asifajrof/CSE316_Term_Project_Tetris/README.md

# CSE316_Term_Project_Tetris
CSE316 Microcontroller et al. sessional. Term Project. Tetris with ATMega32, LED Dot Matrix, LCD, Thumb Joystick, Buzzer

A demonstration video: https://www.youtube.com/watch?v=KJl3XbOa1bw
