asifajrof/CSE316_Term_Project_Tetris/Proposal Present/CSE316_Proposal_Presentation_V3.pptx

## CSE316 Microprocessors, Microcontrollers, and Embedded Systems Sessional

Project Proposal

Group – 39
1705092 – Asif Ajrof
1705093 – Fatima Nawmi

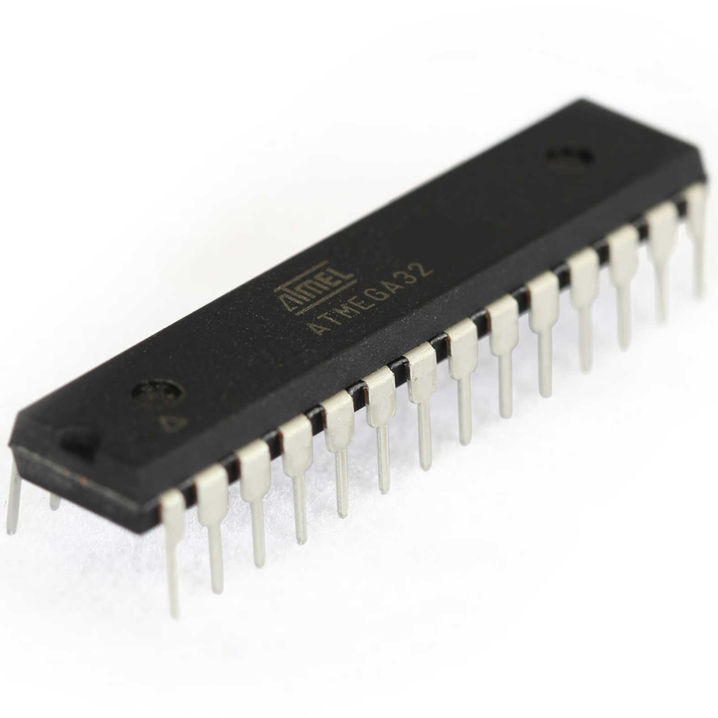
[picture p1: figure]
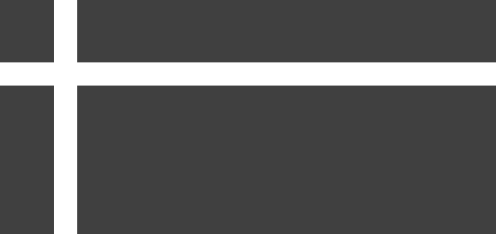
[picture p2: figure]
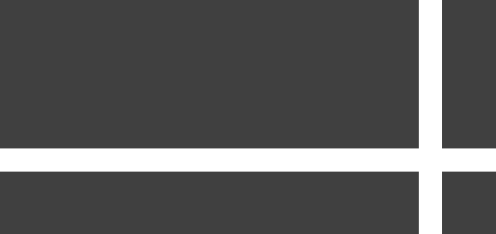
[picture p3: figure]

## What Are We Making?

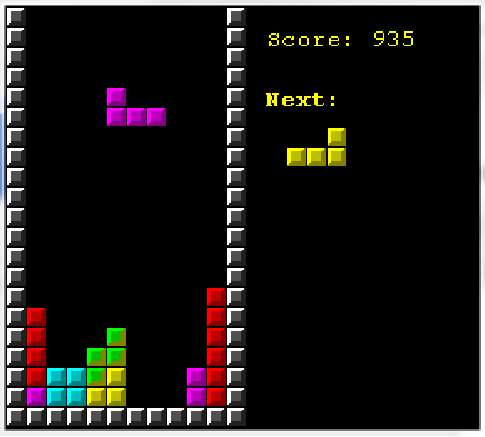
[picture p4: figure]
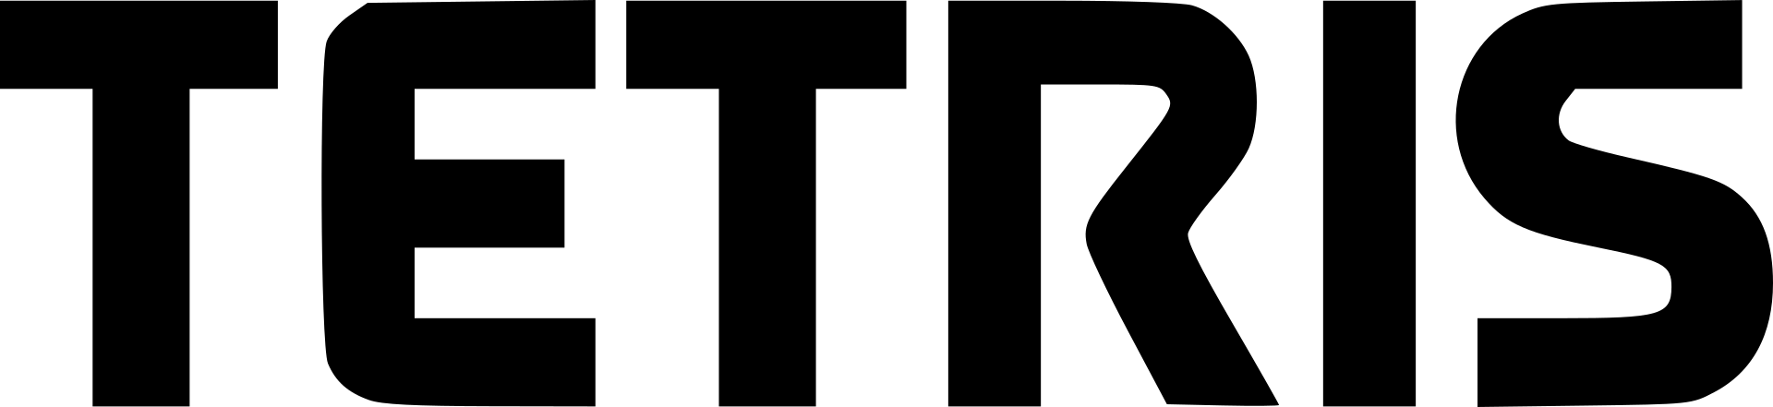
[picture p5: figure]

## Why TETRIS ?

- It will give us a good working knowledge of incorporating multiple components such as LED matrix, LCD screen, Buzzer, Thumb Joystick with Microcontroller.
- Implementing the logistics of the game we will learn first hand how to use logistics in real life hardware.
- Another reason for choosing this particular game is of course the reminiscence of the popular arcade game that we all played growing up.

## How Do We Implement ?

- For the game console we will use two LED dot matrices, and another LED dot matrix for showing the next piece.

## The Movement

- We will use a thumb joystick for movement and rotation of the pieces.
- A Tetris piece can be moved left or right to position and down to drop faster with the joystick.

## Score

- An LCD screen will show the score.
- When a row is filled, it disappears and one point is added. If four rows are filled in one move the point is double.
- The game finishes when the stack of pieces reach the top.

## Sound

- For sound effects, a buzzer will be used.
- The buzzer will make a beep sound on rotations and row fills.

## Components

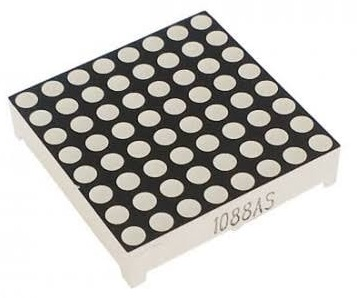
[picture p6: figure]

8x8 LED Dot Matrix 2.4’’

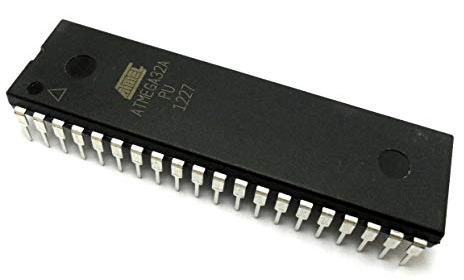
[picture p7: figure]

Microcontroller ATMEGA32

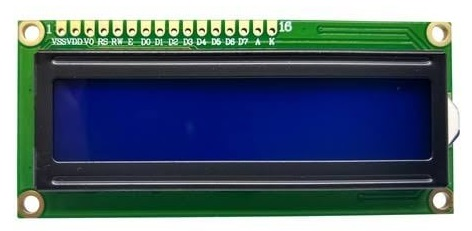
[picture p8: figure]

16x2 LCD Screen

## Components

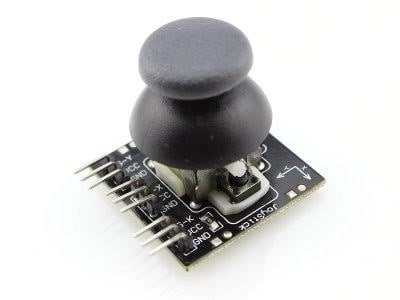
[picture p9: figure]

Analog 2-Axis
Thumb Joystick

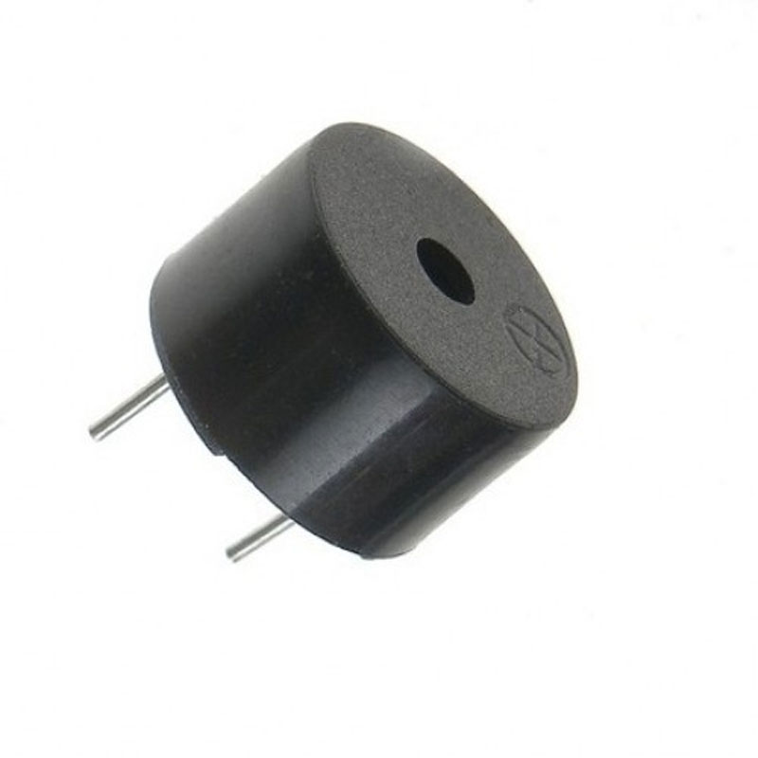
[picture p10: figure]

Buzzer

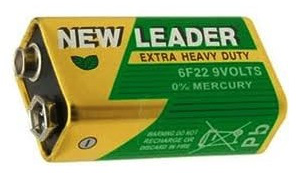
[picture p11: figure]

9V Battery

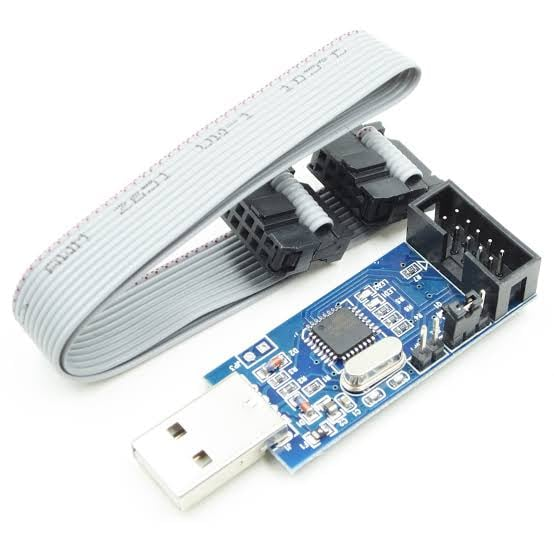
[picture p12: figure]

USBasp Programmer

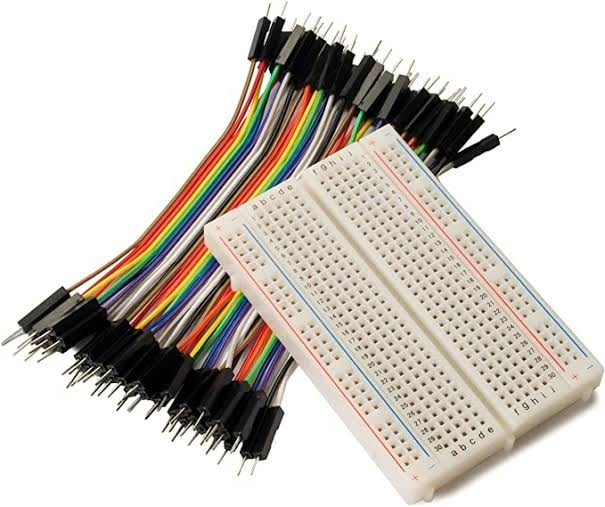
[picture p13: figure]

Breadboard
and Wiring

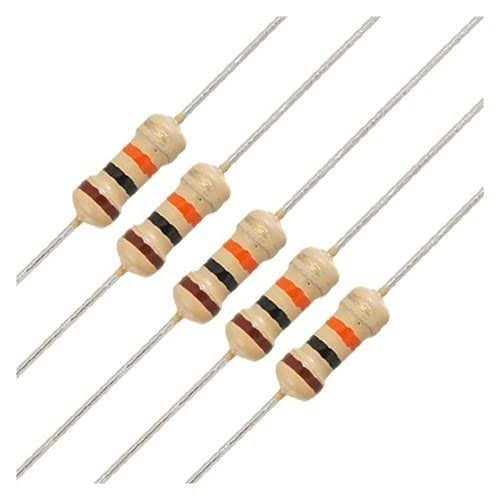
[picture p14: figure]

Resistors

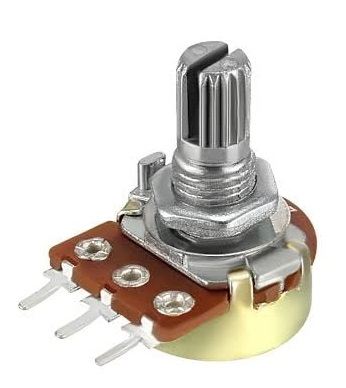
[picture p15: figure]

Potentiometer

## THANK YOU

1705092 – Asif Ajrof 1705093 – Fatima Nawmi
