asifajrof/CSE316_Term_Project_Tetris/Report Tex Project/Group-39-Report.pdf

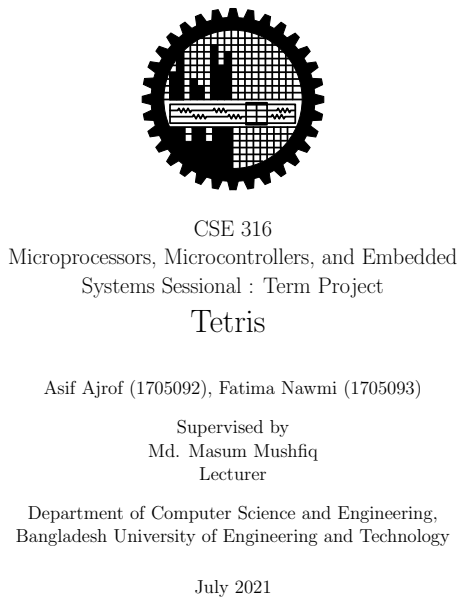
[picture p16: page 1]
CSE 316; Tetris; Lecturer; July 2021

Microprocessors, Microcontrollers, and Embedded

Systems Sessional : Term Project

Asif Ajrof (1705092), Fatima Nawmi (1705093)

Supervised by
Md. Masum Mushfiq

Department of Computer Science and Engineering,
Bangladesh University of Engineering and Technology

## Contents

1 Motivation | 1
2 Components | 1
3 Short Description of Each Module | 1
4 Methods used | 2
5 Algorithm used in gameplay | 3
6 Circuit Diagram | 3
7 Challenges | 5

i

1

## 1 Motivation

Remaking the popular arcade game Tetris in a simple platform using microcontroller and LED matrices.

## 2 Components

The main components of our project are:

1. ATmega32
2. 8x8 LED Dot Matrix (common cathode)
3. 16x2 LCD Screen
4. Thumb Joystick
5. Buzzer

Some other components that were also used:

- USBasp
- Resistor
- Inductor
- Capacitor
- Wire
- Potentiometer

## 3 Short Description of Each Module

We have several different modules in this project. Here is a short description summarizing what each module does individually.

### 3.1 Main Console

The main gaming console is made of two 8x8 LED Dot Matrix, so we have a 16x8 display for the gameplay.

### 3.2 Pieces

We have kept all the 7 different pieces of Tetris game (I,J,L,T,S,Z,O). The pieces are generated randomly, and for each game the pieces are random as well.

We show the next piece to come in the LCD screen.For this we have ensured communication between two ATmega32.

2

### 3.3 Movement

The thumb joystick is used for four possible movements: left, right, down and rotate (up move of joystick). Also, for starting the game we need an up move.

### 3.4 Score Update

When a row is filled the score is updated in the LCD screen and the filled row is removed while the rows above come down to fill up the empty row. When four consecutive rows are filled at the same time, as a bonus double points are added.

### 3.5 Game Speed

After certain time intervals, the game increases its speed. The speed resets when a new game is started again.

### 3.6 Sound

The buzzer makes a sound when there is a score update, a new game starting and when the game is over.

### 3.7 Game over and New game

When there is no more place for a new piece to enter, the game is over. For a new game to begin after the last game is over,the display shows a play button and an up movement is needed.

## 4 Methods used

### 4.1 UART

For having a simplex data transfer we used UART subsystem. We used 9600 bps baud rate for data transmission.

### 4.2 ADC

We have used the ADC chip for collecting analogue movement data from the thumb joystick and converted it to digital for our piece movements.

3

## 5 Algorithm used in gameplay

The algorithm used in gameplay is shown in the following flowchart,

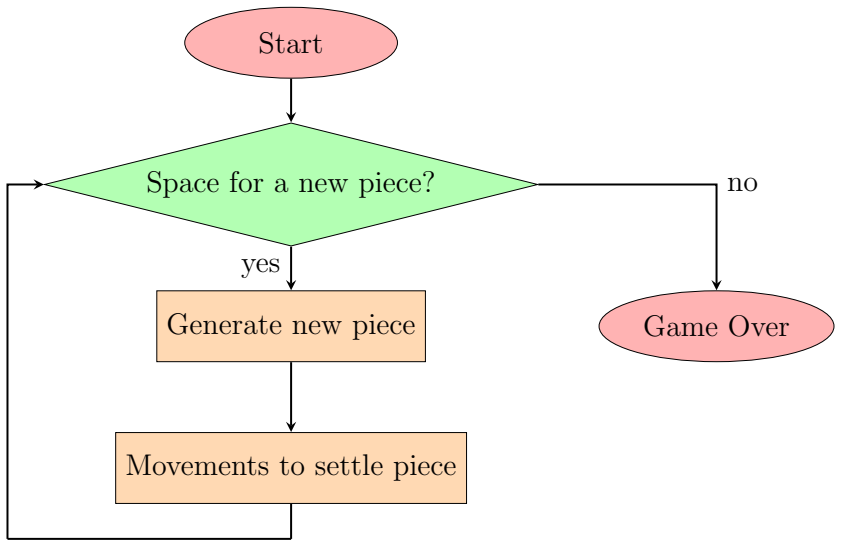
[picture p17: figure]
Start; Space for a new piece?; Generate new piece; Game Over; Movements to settle piece; yes

Figure 1: Algorithm

## 6 Circuit Diagram

- We have used two ATmega32 microcontrollers, U1 and U2 in the Figure 2.
- The main console, i.e., two LED dot matrices are connected to U1. Since we have used two common cathode LED matrices, we have used P ORT C for the common row connection for both LED matrices. For column connection we have connected the upper LED matrix to P ORT B and the lower LED matrix to P A4 − P A7 and P D4 − P D7.
- As we have connected the thumb joystick using the ADC0, ADC1 input, it is connected to P A0 − P A1, also the ground pin of the joystick is connected to the common ground of the circuit and the power pin to the common power source, V CC. We have used AV CC as the voltage source for ADC and for better accuracy and stable voltage we have connected a capacitor (C2) between ground and AREF, another one (C3) between ground and AV CC. For stable current flow we have used an inductor (L1) between AV CC and V CC.
- We have connected the positive end of the the buzzer to P A2 and the negative end to the ground.

4

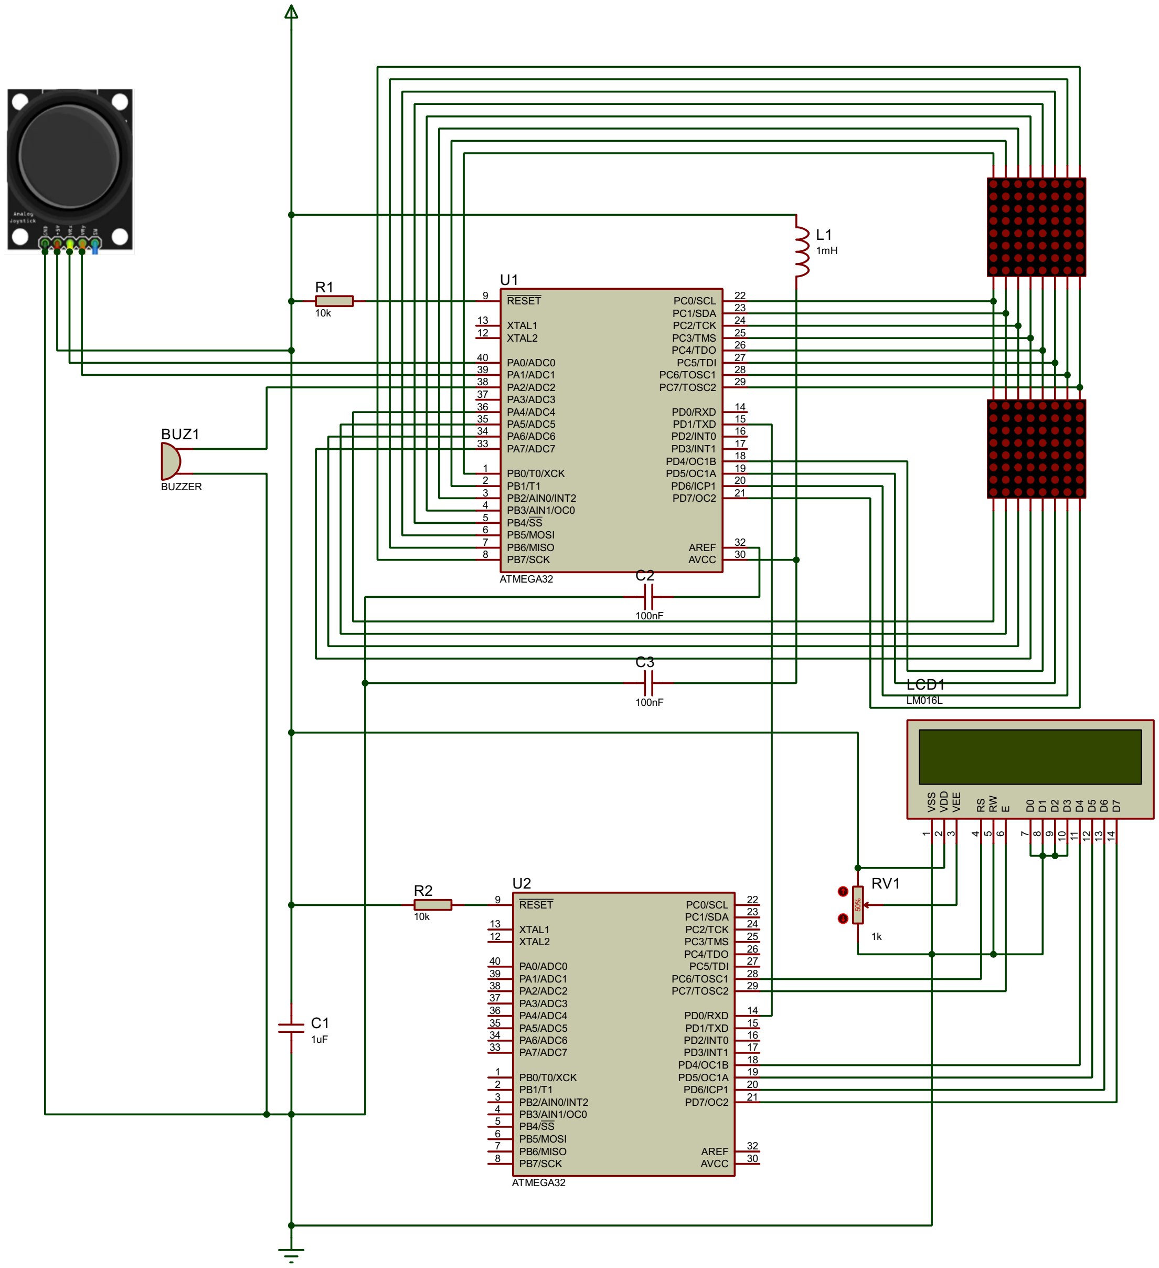
[picture p18: figure]
PB0/T0/XCK; PB2/AIN0/INT2; PB3/AIN1/OC0; PB5/MOSI 6; PB6/MISO; PB7/SCK; RESET; XTAL2; XTAL1; PD0/RXD; 14 PD1/TXD 15 PD2/INT0 16 PD3/INT1 17 PD4/OC1B 18 PD5/OC1A 19 PD6/ICP1 20 PD7/OC2 21; PC0/SCL; 22 PC1/SDA 23 PC2/TCK 24 PC3/TMS 25 PC4/TDO; 26 PC5/TDI; 27 PC6/TOSC1; 28 PC7/TOSC2 29 PA7/ADC7; PA6/ADC6; PA5/ADC5; PA4/ADC4; PA3/ADC3; PA2/ADC2; PA1/ADC1; PA0/ADC0; AREF; 32 AVCC 30; ATMEGA32; BUZ1; BUZZER; 4 VSS; 1 VDD 2 VEE; 3 LCD1

Figure 2: Detailed Pin Diagram

- For establishing UART serial communication between U1 and U2 we have connected the TXD (P D1) pin of U1 to the RXD (P D0) pin of U2.
- We have connected the LCD to U2, using P D4 − P D7 as data lines D4 − D7, and P C6, P C7 as register select and enable pins respectively. As we have used the LCD for only write operations, the Read/Write pin is constantly kept low by connecting it to the ground. Since we have used 4-Bit Mode Interfacing, data pins D0 − D3 are connected to the ground. The V EE pin is connected to a potentiometer for changing the contrast of the display. The V DD pin is connected to power source and the V SS pin is connected to the ground.
- For ensuring stable source voltage we have used a capacitor between source voltage and ground in both U1 and U2 and the reset pin is connected to the V CC.

5

## 7 Challenges

- We noticed that while using UART serial communication the data transfer was delayed by few seconds, for fixing this we tried using a larger Baud rate for a larger bit per second, but after some trial and error even with a larger Baud rate there was some delay, hence when the score gets updated or game over or a new game there is a slight delay before the LCD is updated.
- We faced a problem in our main display LED matrices, every next row was emitting very dim light under the actual positions. We figured since we are multiplexing the rows and columns, and we are changing the row values first and then changing the column values, as a result for a very brief time the columns are getting previous values for an updated row value. We fixed this problem by clearing the values of columns after a short delay in each iteration.
- While implementing the movements a delay was needed because without delay a single press would trigger multiple moves. But a delay function for every movement pauses all the other functionalities. So, instead we kept a variable, that keeps count of the duration of one button press and ensures one movement for one press.
- While designing our main circuit we first wanted to use one ATmega32 with the help of decoders for all our operations. We tried simulating this with Proteus, but we noticed because of using decoder the entire process was becoming very slow. So we excluded this idea from the designing phase and designed with two ATmega32 which also enabled us to learn about the serial communication method.
- Even though we needed simplex serial communication between the two microcontrollers we found that if we did not enable the RXC and TXC of UCSRA registers in both ATmega32 code, it was not working in hardware, but it was working in simulation. Hence we used duplex mode for implementing simplex communication.
- LCD showed garbage values if there was a slight change in voltage, after reconnecting the voltage source this problem went away. For solving this issue we have called the LCD initialization function every time before we write something on the LCD. This clears the garbage values without the necessity to reset.
- Implementing all the logistics of the game into hardware was very challenging. Implementing the same tasks in simulator was widely different than implementing it in hardware.
