asifajrof/CSE316_Term_Project_Tetris/Proposal Present/CSE316.Term.Project.Proposal.Presentation.Group.39.pdf

## Project Proposal

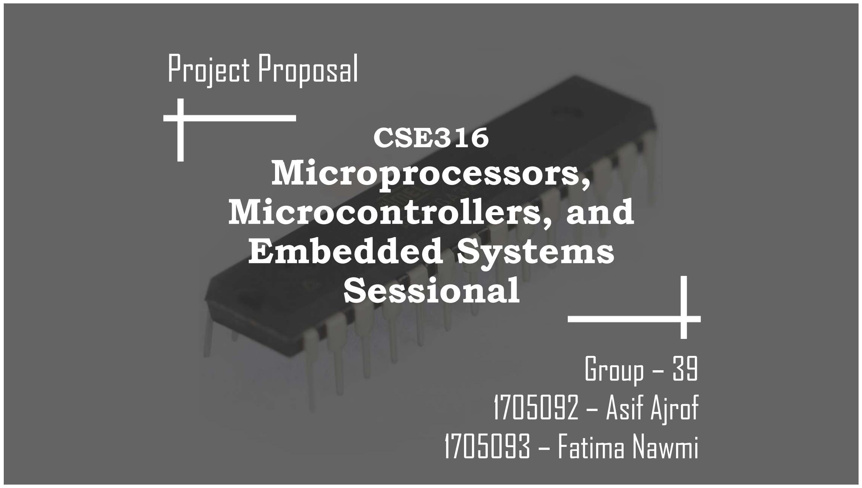
[picture p19: page 1]

CSE316
Microprocessors,

## Microcontrollers, and Embedded Systems Sessional

### Group – 39 1705092 – Asif Ajrof 1705093 – Fatima Nawmi

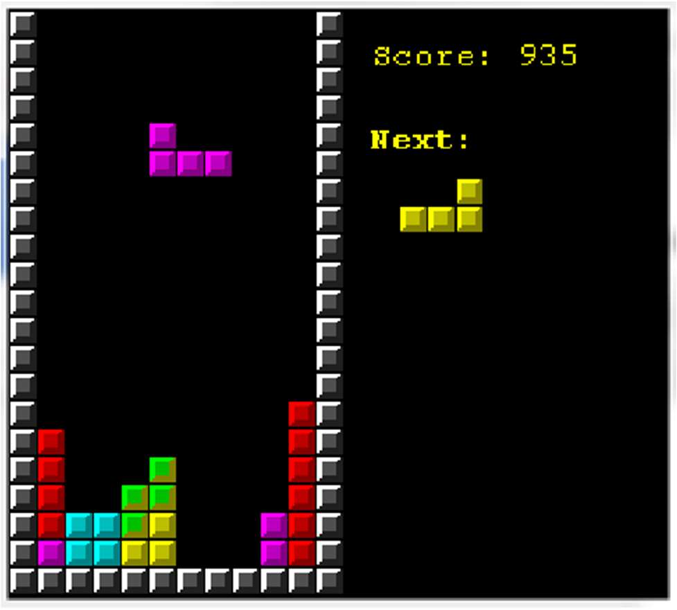
[picture p20: figure]

## What Are We Making?

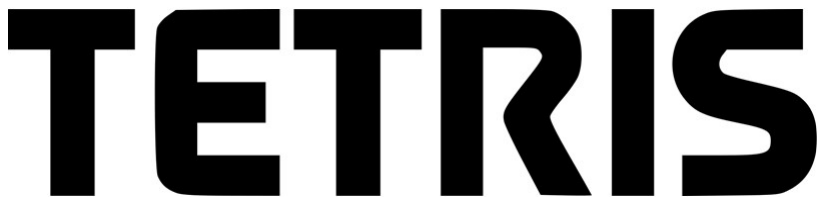
[picture p21: figure]

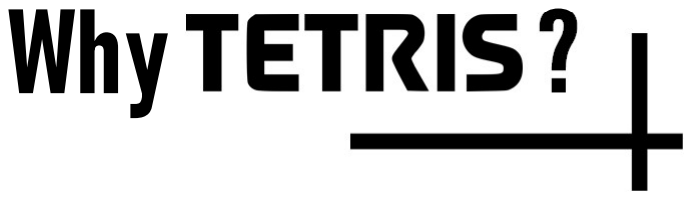
[picture p22: figure]
Why TETRIS ?

It will give us a good working knowledge of incorporating multiple components such as LED matrix, LCD screen, Buzzer, Thumb Joystick with Microcontroller.
Implementing the logistics of the game we will learn first hand how to use logistics in real life hardware.
Another reason for choosing this particular game is of course the reminiscence of the popular arcade game that we all played growing up.

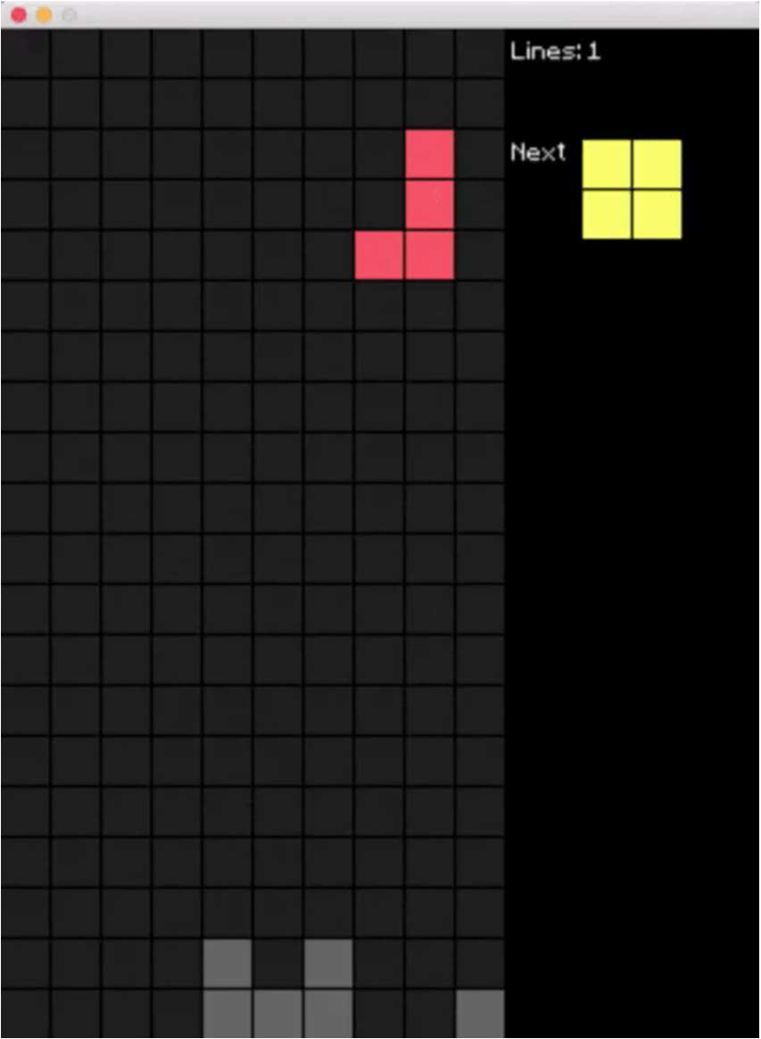
[picture p23: figure]

## How Do We Implement ?

For the game console we will use two LED dot matrices, and another LED dot matrix for showing the next piece.

## The Movement

We will use a thumb joystick for movement and rotation of the pieces. A Tetris piece can be moved left or right to position and down to drop faster with the joystick.

## Score

An LCD screen will show the score. When a row is filled, it disappears and one point is added. If four rows are filled in one move the point is double.
The game finishes when the stack of pieces reach the top.

## Sound

For sound effects, a buzzer will be used.
The buzzer will make a beep sound on rotations and row fills.

## Components

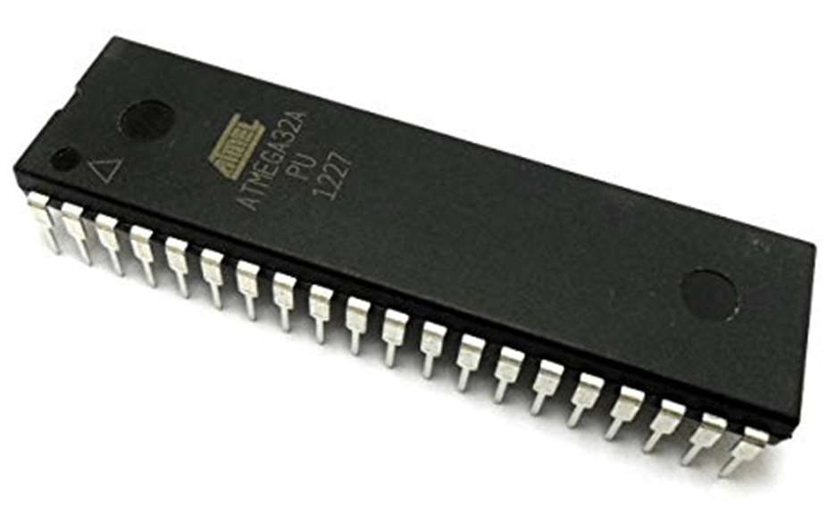
[picture p24: figure]

Microcontroller
ATMEGA32

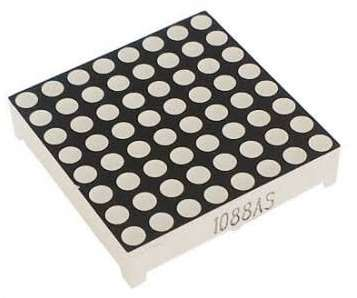
[picture p25: figure]

8x8 LED Dot Matrix 2.4’’

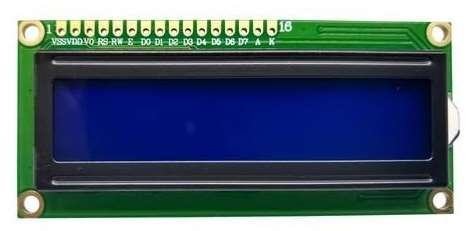
[picture p26: figure]

16x2 LCD Screen

## Components

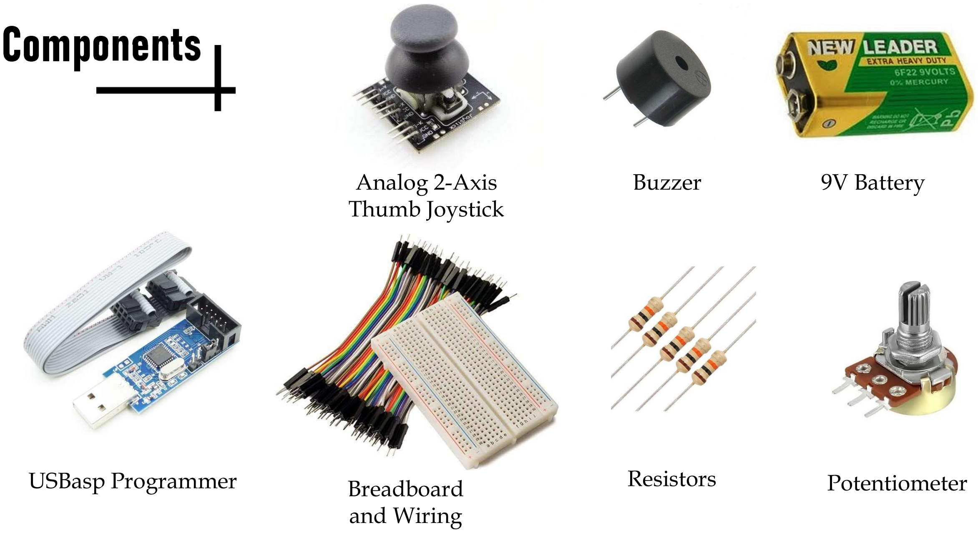
[picture p27: page 9]

Analog 2-Axis
Thumb Joystick

Buzzer

USBasp Programmer

9V Battery

Breadboard | Resistors | Potentiometer
and Wiring

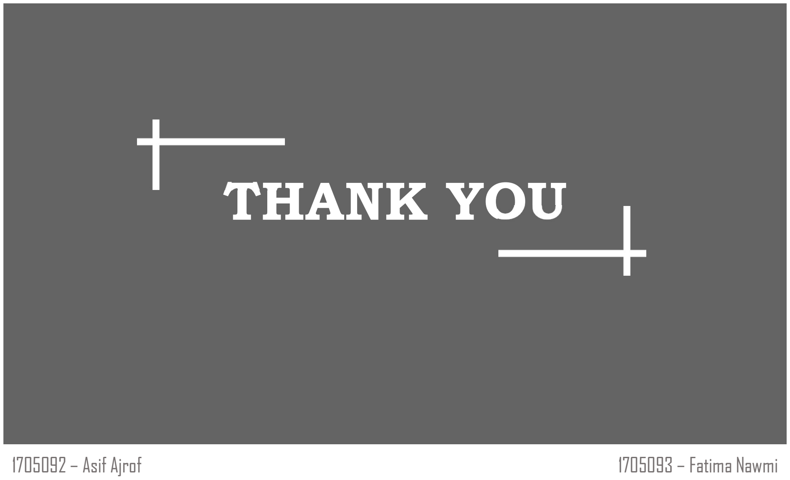
[picture p28: page 10]

# THANK YOU

1705092 – Asif Ajrof | 1705093 – Fatima Nawmi
