asifajrof/CSE316_Term_Project_Tetris/Report Tex Project/figures/BUET_logo.pdf

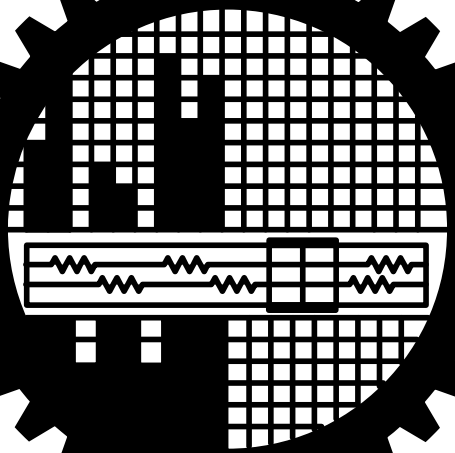
[picture p29: figure]
