asifajrof/CSE316_Term_Project_Tetris/Circuits/finalckt.png

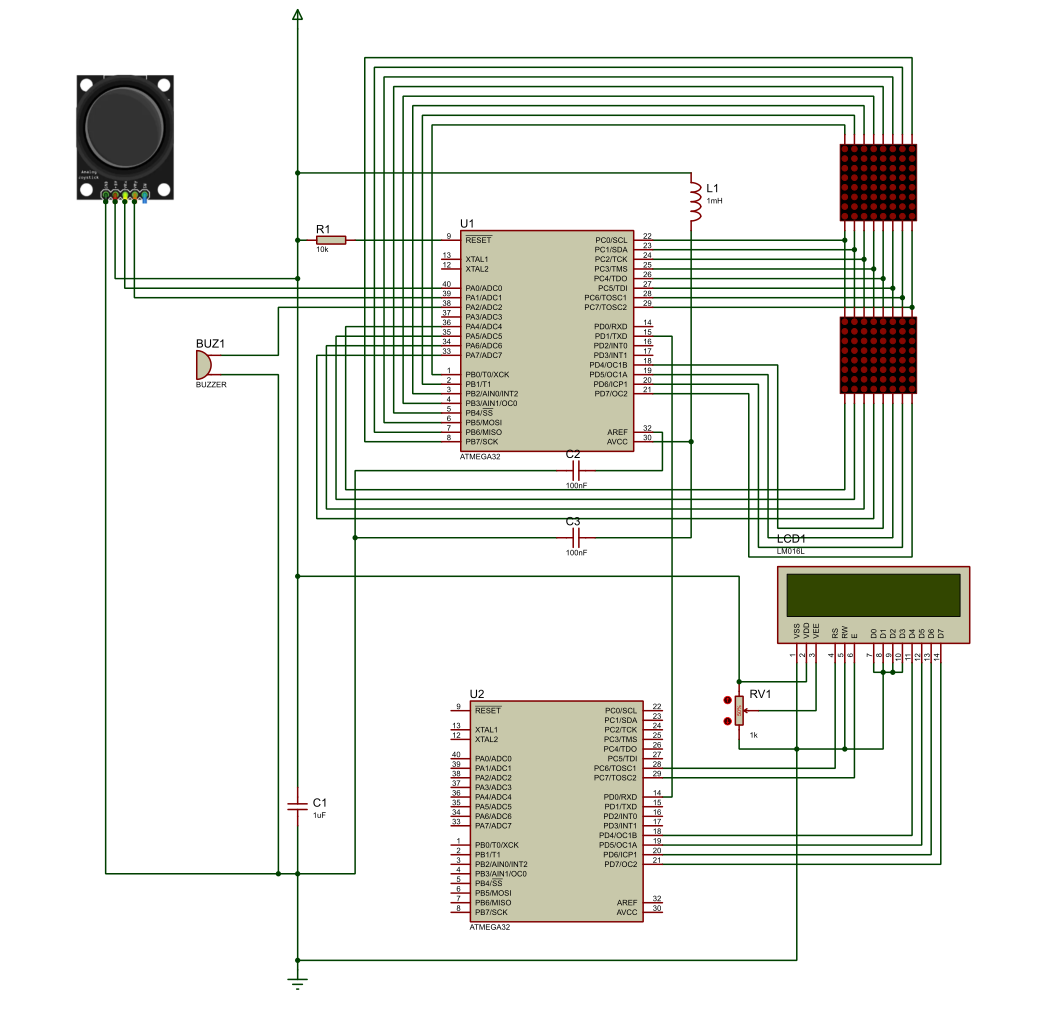
Circuits/finalckt.png
