asifajrof/CSE316_Term_Project_Tetris/workfiles/shapes.png

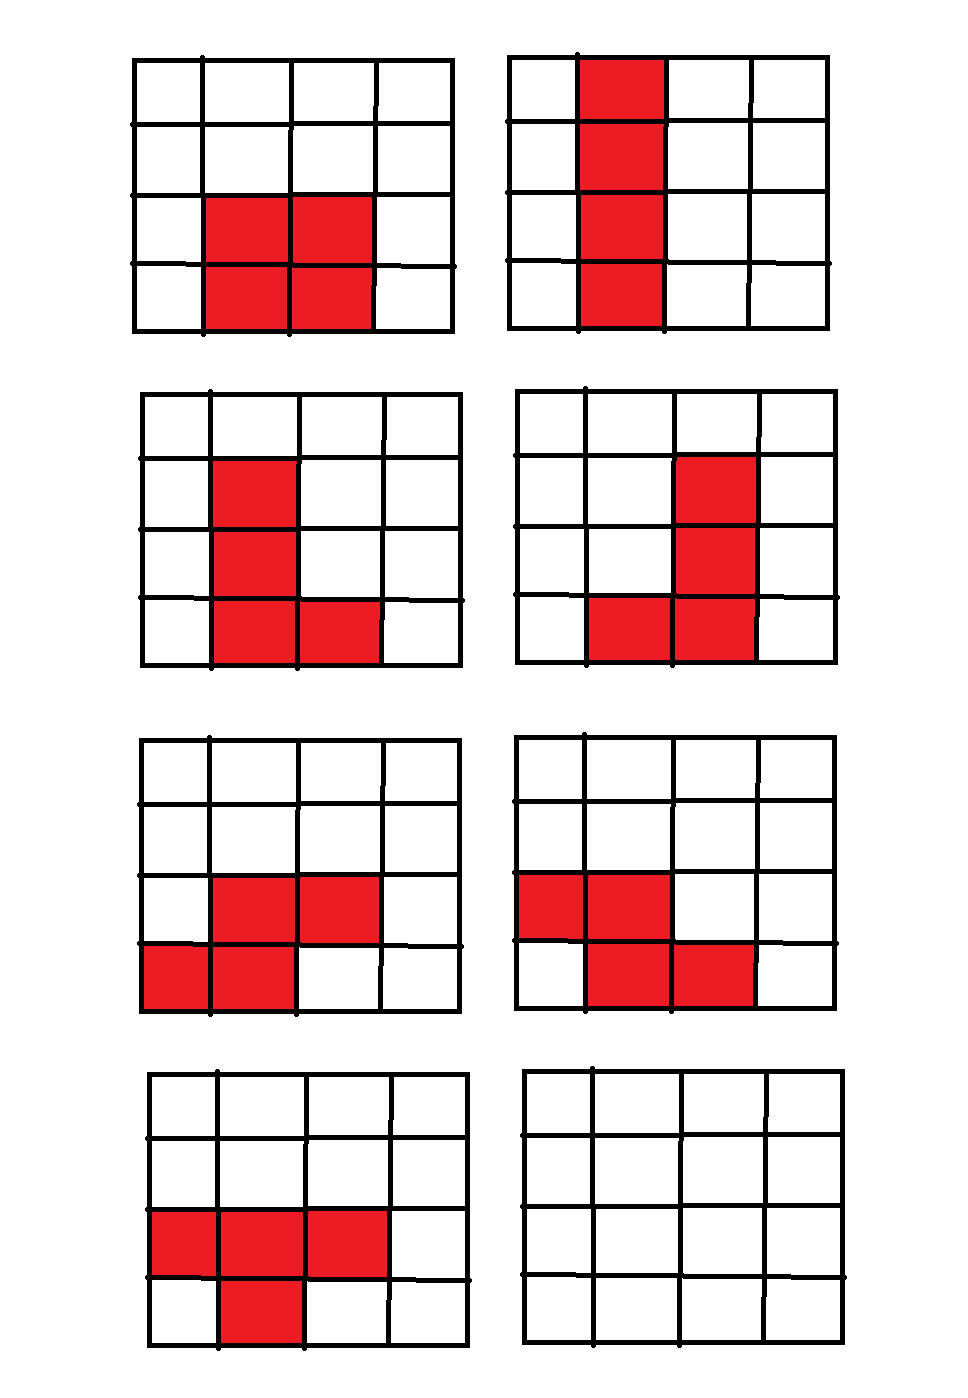
workfiles/shapes.png
