asifajrof/CSE316_Term_Project_Tetris/Report Tex Project/figures/circuit_final1.pdf

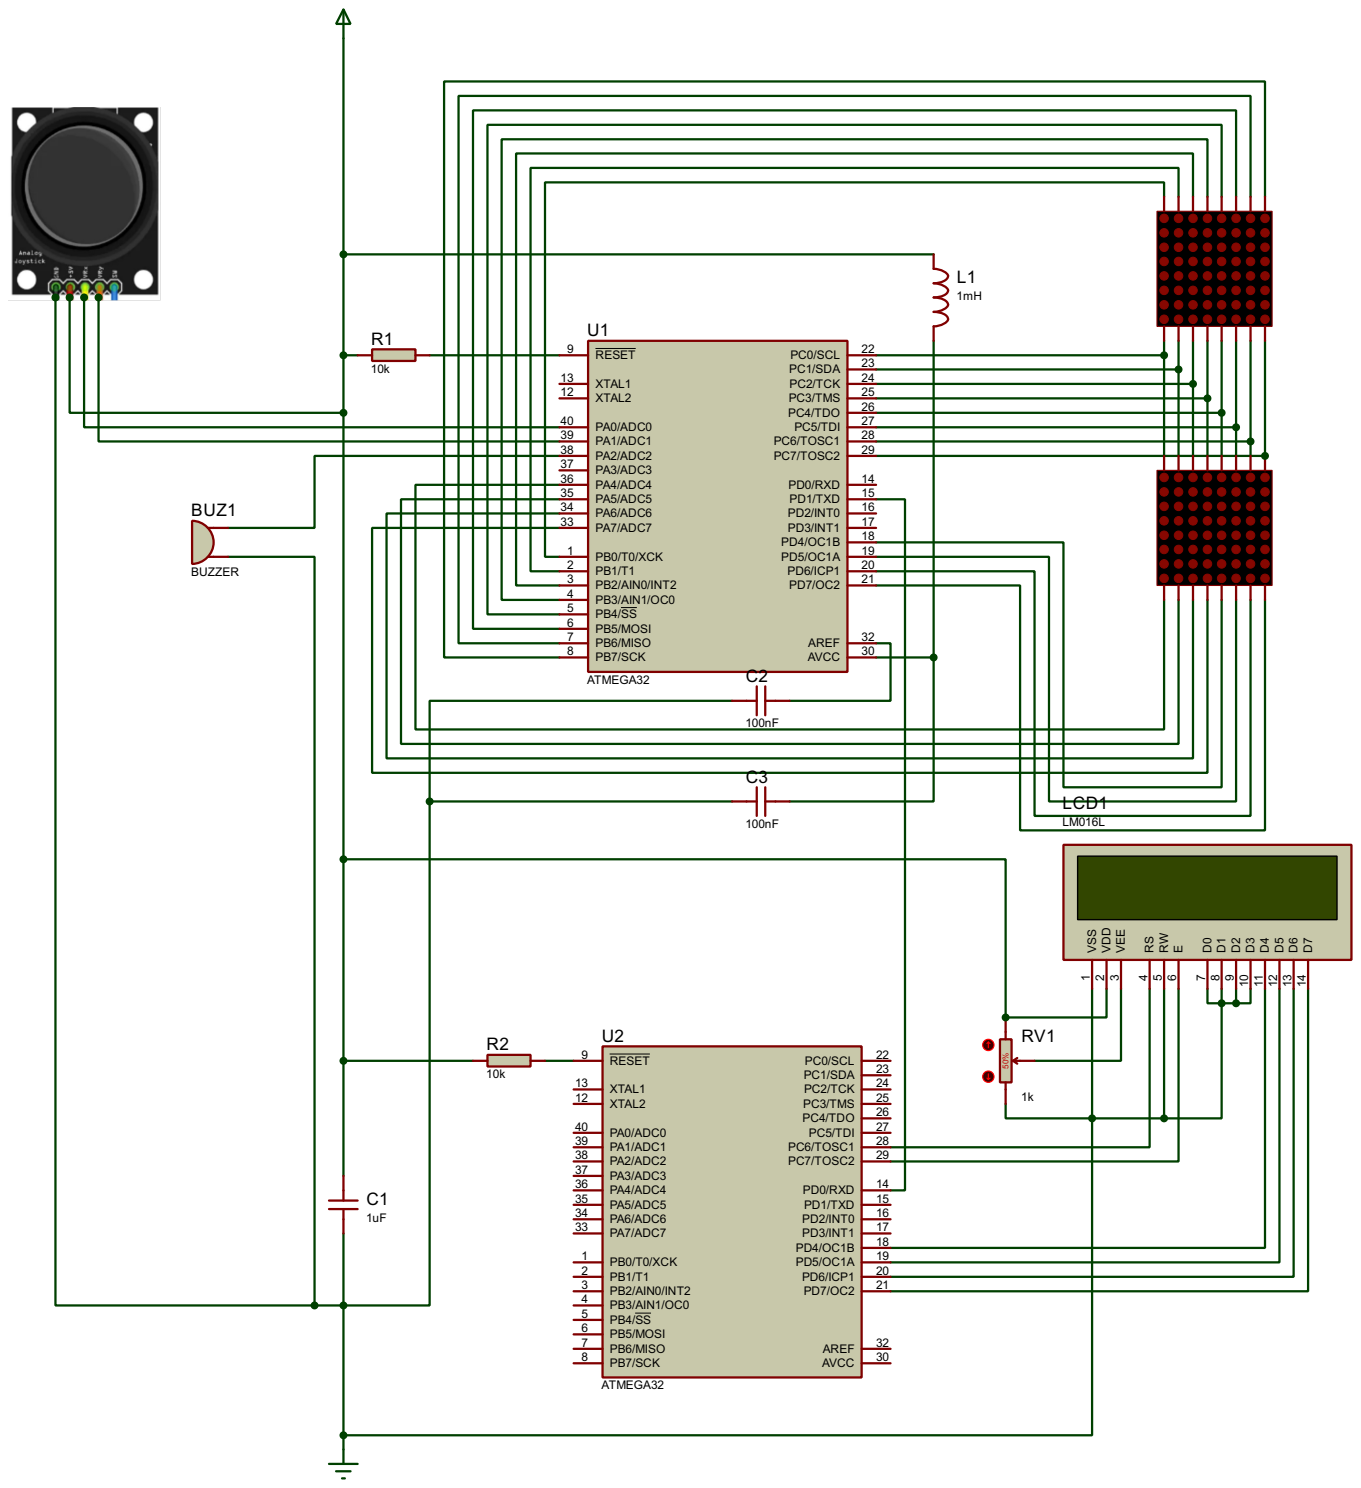
[picture p32: page 1]
