asifajrof/CSE316_Term_Project_Tetris/(list of files, drawings)

Other design files:
Circuits/finalckt.pdsprj
Circuits/firstDraftckt.pdsprj
Circuits/seconfDraftckt.pdsprj
First Version with Simulation/firstDraftckt_redesigned.pdsprj
workfiles/2atmegadirect/usart connection testing/usart.pdsprj
workfiles/buzzer with relay ckt/buzzer_with_relay.pdsprj
workfiles/check_hardware/lcd_try/lcd_try_circuit.pdsprj
workfiles/Codes/firstDraftckt.pdsprj
workfiles/Codes/test with one atmega/sentiamisenti.pdsprj
workfiles/communicate_betwn_atmegas/communicate_betwn_atmegas.pdsprj
workfiles/communicate_betwn_atmegas_buzzer/communicate_betwn_atmegas.pdsprj
workfiles/interrupt_trigger/1705092LEDCircuit.pdsprj
workfiles/multiple led using decoder/multipleLEDwithDecoder.pdsprj
workfiles/Test_folder/Testckt.pdsprj
workfiles/uart_try_again/uart_try_again.pdsprj
workfiles/usart connection testing/usart.pdsprj
