asifajrof/CSE316_Term_Project_Tetris/(commit log)

2021-06-17 Upload trial code
    Interrupt trigger from code
    [1705092LEDCircuit.pdsprj]
2021-06-17 Upload Communicate Between Two ATMega trial files
    Direct connection to communicate between 2 atmega32
    [communicate_betwn_atmegas.pdsprj]
2021-06-17 Update files
    [communicate_betwn_atmegas.pdsprj]
2021-06-17 Update trial files
    [communicate_betwn_atmegas.pdsprj]
2021-06-17 Create firstDraftckt.pdsprj
    First Try of Circuit(no next piece)
    [firstDraftckt.pdsprj]
2021-06-17 buzzer relay demo
    [buzzer_with_relay.pdsprj]
2021-06-17 error correction for set_shape
    [main.c]
2021-06-18 Trial for USART connection
    [seconfDraftckt.pdsprj, usart.pdsprj]
2021-06-18 multiple led with decoder trial
    [multipleLEDwithDecoder.pdsprj]
2021-06-19 Multiple LED with decoder changed
    [multipleLEDwithDecoder.pdsprj]
2021-06-19 ckt added to code folder
    [firstDraftckt.pdsprj]
2021-06-19 second atmega
    [firstDraftckt.pdsprj]
2021-06-19 test uart added
    [Testckt.pdsprj]
2021-06-19 first draft ckt redesign
    [firstDraftckt_redesigned.pdsprj]
2021-06-19 first draft circuit printed
    [firstDraftckt_redesigned.pdsprj]
2021-06-22 score update in go down check
    [firstDraftckt_redesigned.pdsprj]
2021-06-22 bug of score update fixed, implementation code uploaded
    [firstDraftckt_redesigned.pdsprj]
2021-06-26 lcd connection, restart code in 1st atmega
    [lcd_try_circuit.pdsprj]
2021-07-01 one module using one atmega
    [firstDraftckt_redesigned.pdsprj, sentiamisenti.pdsprj]
2021-07-14 joystick , buzzer
    [usart.pdsprj]
2021-07-15 try for third lcd with uart interrupt
2021-07-16 play button
2021-07-17 tetris point, movement freeze fix
    [main.c]
2021-07-20 final ckt half
    [final1.pdsprj]
2021-07-29 report - lcd init
    [final1.pdsprj]
2021-07-29 shajano guchano
    [firstDraftckt.pdsprj, firstDraftckt_redesigned.pdsprj, lcd_try_circuit.pdsprj, sentiamisenti.pdsprj]
